matellier/led-candle/models/freecad/candle.FCStd

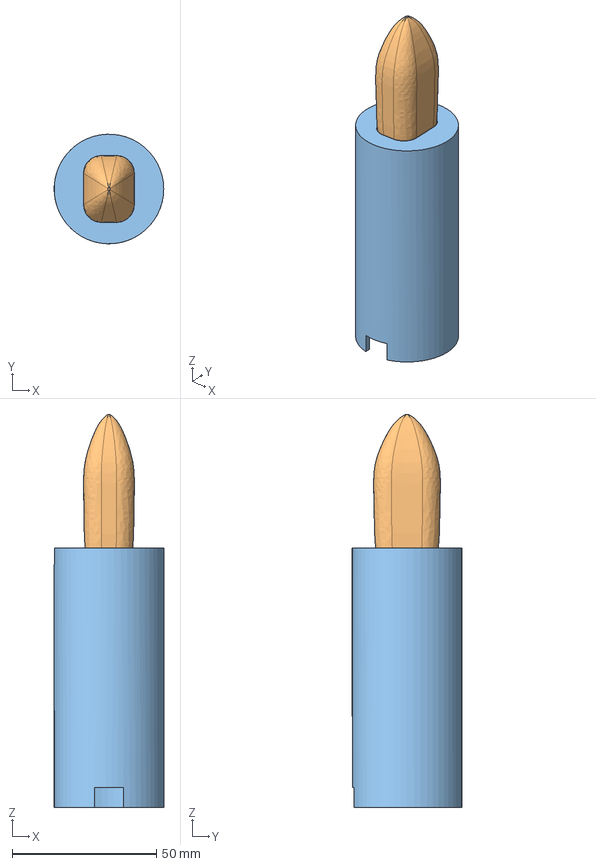
[picture p1: CAD file, 2026-10-18]
models/freecad/candle.FCStd
38.0 x 38.0 x 136.2 mm
Fin
Diffuser
Base
ref_strip_front
ref_strip_back
ref_bend
ref_led_front1
ref_led_back1
ref_led_front2
ref_led_back2
