matellier/led-candle/models/stl/candle_base.stl

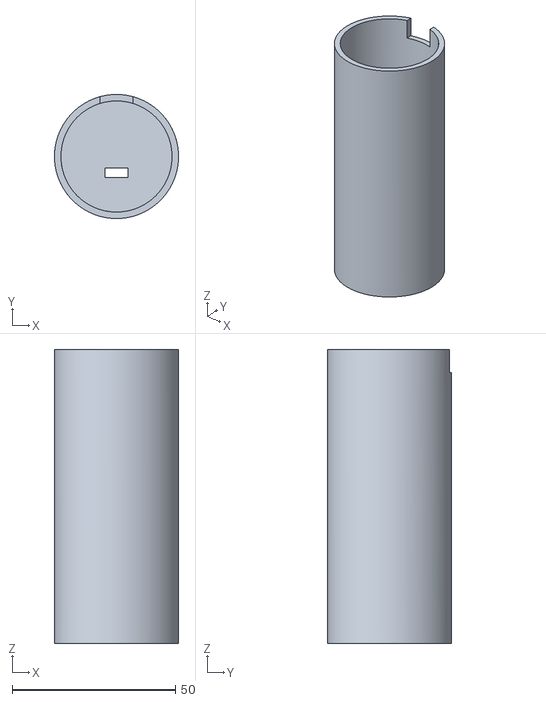
[picture p2: CAD file, 2026-10-18]
models/stl/candle_base.stl
38.0 x 38.0 x 90.0
