matellier/led-candle/models/stl/candle_diffuser.stl

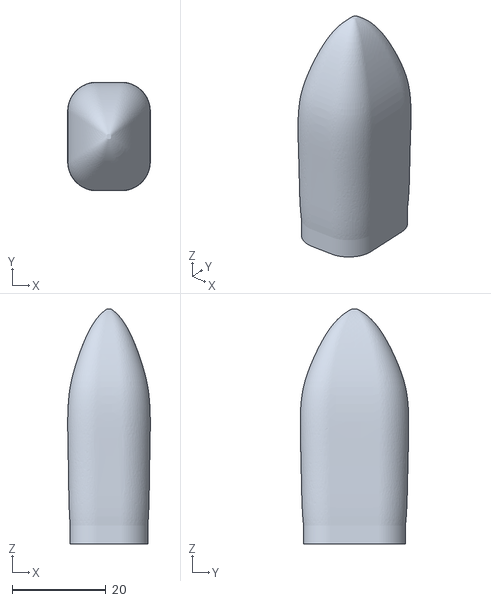
[picture p3: CAD file, 2026-10-18]
models/stl/candle_diffuser.stl
17.7 x 23.2 x 50.2
