matellier/led-candle/models/stl/candle_fin.stl

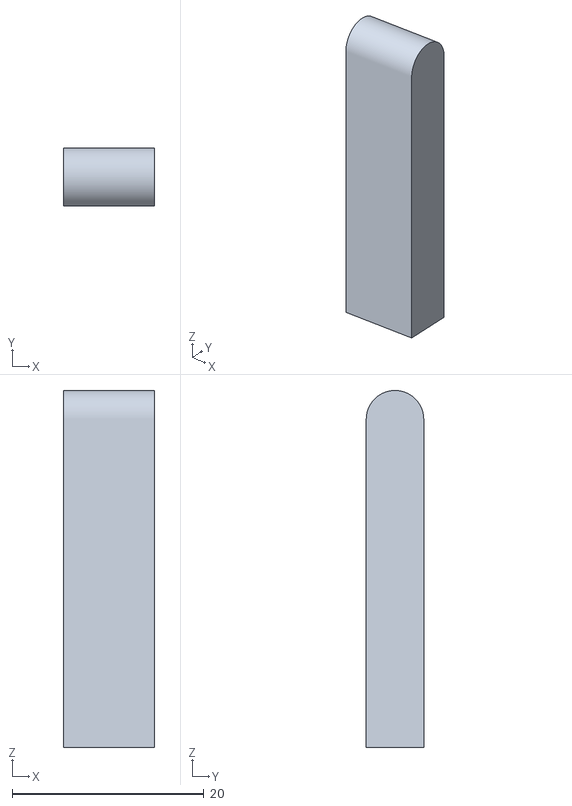
[picture p4: CAD file, 2026-10-18]
models/stl/candle_fin.stl
9.50 x 6.00 x 37.2
