matellier/led-candle/(commit log)

2026-08-12 Add non-blocking coil pulse for magnet flicker alongside LED
    Drives the solenoid/inductor on pin 7 with short (1-5ms) pulses at
    random 200-1500ms intervals, loosely synced to the LED flicker updates
    so the physical nudge and visual flicker feel correlated without being
    perfectly locked together. Both effects now run off millis() timers
    instead of delay() in the main loop.
    [candle_flicker1.ino]
2026-08-13 add inductor to led
2026-10-05 Add stage 1 steady LED and stage 2 flicker sketches with roadmap
    Restart the project on a single 5mm white LED driven from D9 through
    150 ohm. Stage 2 compares three PWM flicker modes; mode 3 (smooth walk
    + flutter + gust dips) was chosen by eye and is now the default.
    Also adds the stage 1 wiring/schematic doc, a staged roadmap to
    production, the components list, and the flicker comparison log.
2026-10-05 Add stage 3 two-LED side-by-side diffuser comparison
    Drives LED A on D9 and LED B on D10 from the same mode 3 flicker so
    differences come only from the flame print. Cycles both -> A -> B every
    10 s, with serial commands to hold a phase. D10 is used instead of D8
    because D8 has no PWM.
2026-10-05 Log stage 3 result and move to WS2812B addressable LEDs
    The 5mm LED is too dim to see from ~50 ft regardless of filament, so
    diffuser tests pause until the LED is chosen. Roadmap stage 5 now
    targets the on-hand WS2812B strip, records the rejected options, the
    18650 battery direction, and the open questions for the next session.
2026-10-10 Move stage 5 to ESP32 + WLED on USB power, prototype first
    Drop the 18650/Pro Mini plan: 8-15 pixels visible at 50 ft drain a cell
    in 2-3 nights. Each of the 12 candles gets a 5V USB charger and an ESP32
    running WLED for Home Assistant control.
    Prototype one candle on the on-hand ESP32-WROOM-32 DevKit before buying
    production parts. Add the wiring diagram and WLED setup for the 144/m
    strip wrapped on the 18 mm post, and split components.md into the
    on-hand prototype, the production parts list and shelved parts.
2026-10-11 Log stage 5 bring-up fixes and plan diffuser gap test
    - WLED flashing steps (hold BOOT, disconnect external wiring) and HA setup
    - Fix GND location: the terminal next to 5V on the breakout is CMD (flash),
    which stopped the ESP32 booting once the strip was powered
    - P16 location on the breakout; 470 uF 16 V cap on hand; 16 px on a ~16 mm post
    - Stage 7 diffuser test 1: 30 vs 36 mm ID vase-mode cylinder, with a
    light-uniformity model pointing to an ~8 mm LED-to-diffuser gap
2026-10-11 Remove data resistor and bulk cap from stage 5 prototype
    The strip vendor's wiring diagram uses neither and the prototype runs fine
    without them. Docs now match the as-built wiring: 16 px, wires soldered to
    the DIN-end pads (red 5V, teal GND, white DIN). R1/C1 kept as spares.
2026-10-17 Add fin + hairpin strip candle model (base, fin, diffuser)
    - Stage 7: one uncut 5 px strip folded over a printed fin (2 up the street
    face, 1 on top, 2 down the room face) replaces the round post, shrinking
    the diffuser from ~26 mm to ~18 mm wide
    - Parametric FreeCAD model driven by a params spreadsheet, generator and
    fit-check scripts, and print-oriented STLs
    - Diffuser uses a rounded-rectangle section (LED envelope offset by the gap)
    so every point stays ~5 mm from the nearest LED
    - Log the post diffuser test result and the rejected light-pipe/fiber idea
2026-10-18 Rebuild candle model as PartDesign bodies; fin uses 180° bend on 60/m strip
    - One PartDesign Body per printed part (Base, Fin, Diffuser), fully
    constrained sketches driven by the params spreadsheet
    - Pixels are ~16.7 mm apart, so the strip bends 180° over the fin's round
    top in the gap between px2 and px3 (4 px, sides stuck down only)
    - Correct strip density everywhere: the reel on hand is 60/m, not 144/m;
    144/m is a purchase only if the prototype needs it
2026-10-18 Hollow the diffuser and refine the candle model in the FreeCAD GUI
    - Diffuser is now a real 0.8 mm shell, open at the bottom (CavityOpen pocket +
    Cavity subtractive loft), so it slices without infill and no longer needs
    vase mode. Wall measured 0.76-0.88 mm; top 2.3 mm of the tip is solid.
    - Even, gently changing loft sections remove the pinch near the base
    (LED gaps 5.2-5.3 mm, were 4.7-4.8); rounded tip, flame 46 mm tall.
    - Fin socket depth equals the plug depth so the strip start sits flush.
    - Generator runs inside the GUI (macro or MCP bridge) so parts open visible
    and coloured.
    - check_fit.py measures to the real inner wall and checks diffuser overlap.
    - Add .mcp.json for the lo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
